ilaykid/robi-firmware/case/Robi_v4/README.md

# רובי (Robi) – מארז רובוט ל-Waveshare ESP32-S3-Touch-AMOLED-1.75 (גרסה 4, "רובי החסון")

מארז מודפס בתלת־ממד ללוח **ESP32-S3-Touch-AMOLED-1.75 בגרסה הרגילה, בלי קופסה (מק"ט 31261)**.
אותה דמות ואותן התאמות ללוח כמו ב-v3.1 (המסך, PWR, BOOT, USB-C, microSD, מיקרופונים), אבל בנוי להחזיק מעמד מול ילדים.
מידות הלוח נלקחו משרטוט המידות של Waveshare ולא אומתו מחדש מאז, ולכן מדפיסים קודם את `fit_test` ואת שני חלקי הראש.

**גודל:** ראש 72×68×28 מ"מ, גוף 62×40×42 (82 מ"מ רוחב עם הידיים), בסיס 78×78, גובה כ־143 מ"מ כולל האנטנה.

## מה השתנה ב-v4 (29.10.2026)
| מה | ב-v3.1 | ב-v4 |
|---|---|---|
| קירות | 2.2 מ"מ | **3.2 מ"מ** |
| צוואר | צינור בקוטר 14 מ"מ, מודבק | **חוליה בקוטר 30 מ"מ**. שני ברגי M3×20 מהדקים ראש, חוליה וגוף |
| בסיס | 3 מ"מ, רגליים | **לוח בעובי 8 מ"מ, 78×78**, בולט 24 מ"מ מאחורי הגוף. כיס למשקולת. 4 ברגי M3 |
| אוזניים | 3 מ"מ, פינים של 2 מ"מ | 5 מ"מ, פינים של 3 מ"מ |
| אנטנה | גבעול 3.4 מ"מ | גבעול 6 מ"מ, כדור 13 מ"מ, יושבת בשקע עם שיפוע |
| יציבות | נופל אחורה מדחיפה של כ־35 גרם במרכז המסך | **כ־89 גרם**, ועם 44 גרם משקולת בכיס **כ־110 גרם** (פי 3) |
| משקל | כ־99 גרם | כ־186 גרם בלי משקולת (כולל הלוח, הסוללה והרמקול) |

## תוכן התיקייה
| קובץ | מה זה | כיוון הדפסה | PLA משוער |
|---|---|---|---|
| `robi_fit_test.stl` | **להדפיס ראשון!** טבעת ניסיון לבדיקת התאמת הזכוכית | כמו שהוא | 3 גרם |
| `robi_head_front.stl` | חזית הראש (פנים) | הפנים על המשטח (כבר מסובב) | 12 גרם |
| `robi_head_back.stl` | גב הראש עם עמודי הברגים | הגב על המשטח (כבר מסובב) | 25 גרם |
| `robi_body.stl` | גוף עם רשת לרמקול, לב וידיים | הפוך, החלק העליון על המשטח (כבר מסובב) | 37 גרם |
| `robi_base.stl` | בסיס עם כיס למשקולת, מגש לסוללה ועמודים לרמקול | כמו שהוא | 49 גרם (במילוי 100%) |
| `robi_neck.stl` | חוליית הצוואר | כמו שהוא | 5 גרם |
| `robi_antenna.stl` | אנטנה | עומדת על הפין | 2 גרם |
| `robi_ear_left.stl` | אוזן שמאל, טבעת סביב ה-USB-C | הפינים למעלה | 1 גרם |
| `robi_ear_right.stl` | אוזן ימין, עם חלון לכרטיס microSD | הפינים למעלה | 1 גרם |
| `robi_pwr_button.stl` | פין לחיצה, אורך רגיל. **מדפיסים 2:** ל-PWR ול-BOOT | עומד על הכובע | 0.3 גרם |
| `robi_pwr_button_short.stl`, `robi_pwr_button_long.stl` | אותו פין, קצר או ארוך ב־0.4 מ"מ | עומד על הכובע | 0.3 גרם |
| `robi.scad` | קובץ המקור הפרמטרי (OpenSCAD) | — | — |

**סה"כ כ־136 גרם PLA.** כל החלקים מודפסים בלי תמיכות (supports).

## גישה לכל רכיבי הלוח
| רכיב בלוח | איך מגיעים אליו |
|---|---|
| מסך מגע | חלון של 47 מ"מ עם שיפוע. אצבע מגיעה כמעט עד הקצה התחתון |
| כפתור PWR | פין כתום בפינה הימנית העליונה. מדליק, והחזקה של 4 שניות מכבה |
| כפתור BOOT | פין כתום בפינה הימנית התחתונה. לחיצה מתחילה או עוצרת שיחה. **לחיצה בזמן ההדלקה פותחת הגדרת Wi-Fi**, אז מחכים שהפרצוף יופיע |
| USB-C | דרך האוזן השמאלית, פתח 14.4×8.8 מ"מ |
| חריץ microSD | דרך החלון באוזן הימנית, עם פינצטה |
| מיקרופונים | שני חורים בגב הראש |

## הגדרות הדפסה
- **חומר:** PLA או PETG.
- **בסיס:** **מילוי 100%** (או לפחות 50%). הוא המשקולת של רובי.
- **שאר החלקים:** 4 קירות, מילוי 20%, שכבה 0.2 מ"מ. לחזית הראש עדיף 0.16, והשכבה הראשונה צריכה להיות נקייה.
- **צבעים מומלצים:** ראש וגוף לבנים. אוזניים, צוואר ובסיס בתכלת. אנטנה ופינים בכתום.

## חומרה נדרשת
| פריט | כמות |
|---|---|
| Waveshare ESP32-S3-Touch-AMOLED-1.75 (31261) | 1 |
| רמקול 2030, 8Ω 2W (30×20×6.8 מ"מ), כבל של לפחות 10 ס"מ | 1 |
| סוללת LiPo 1S עם מעגל הגנה (ראו למטה) | 1 |
| ברגי **M2×16** (לוח לראש). ברגי מכונה, לא ברגים לפלסטיק | 3 |
| ברגי **M2×20** (חיבור שני חלקי הראש) | 4 |
| ברגי **M3×20** (ראש, צוואר וגוף) | 2 |
| ברגי **M3×12** (בסיס לגוף, מלמטה) | 4 |
| משקולת לכיס בבסיס: מטבעות או דסקיות פלדה, עד 44 גרם | — |
| דבק CA לאוזניים ולאנטנה, ודבק לא חובה למשקולת | מעט |
| 4 רגליות סיליקון דביקות מתחת לבסיס | 4 |

### איזו סוללה נכנסת
| מידה (כולל כרטיס ההגנה) | מקסימום |
|---|---|
| אורך (הצד שממנו יוצאים החוטים) | 50 מ"מ |
| עובי | 15 מ"מ |
| גובה (כשהסוללה עומדת) | 31 מ"מ |
| אורך החוטים עד המחבר | לפחות 12 ס"מ |
| מחבר | MX1.25 דו־פיני, **והקוטביות חייבת להתאים ללוח** |

מתאים: 103040 (1000–1200mAh), ובדוחק גם 104050 (1500–1800mAh) אם הגובה שלו עד 31 מ"מ כשהוא עומד.

## סדר הרכבה
1. **בדיקת התאמה:** הדפס את `fit_test` והנח עליו את הלוח עם הזכוכית כלפי מטה. הזכוכית צריכה להיכנס בלי כוח ובלי משחק. אם צריך, שנה את `pocket_d`.
2. **בדיקה בראש:** הדפס את שני חלקי הראש, הנח בהם את הלוח, ובדוק ש-USB-C ו-microSD מול הפתחים ושהפינים לוחצים ("קליק").
3. **כפתורים:** הנח פין מהצד בכל אחד משני חצאי התעלות בחזית הראש. הכובע בחוץ, הטבעת הקטנה בתוך החלק הרחב של התעלה. בוחרים אורך לכל כפתור בנפרד:
   - לחיצה לא עושה כלום: פין `long`.
   - PWR מתנהג כאילו לחוץ כל הזמן: פין `short`.
   - **BOOT: אם רובי לא עולה (מסך שחור), הפין ארוך מדי**, כי BOOT לחוץ בהדלקה מכניס את הלוח למצב צריבה. פין `short`.
4. **מסך:** הנח את הלוח בחזית הראש. ה-USB-C פונה **שמאלה** כשמסתכלים על הפנים.
5. **רמקול:** החלק אותו בין המסילות בגוף מלמטה, צד הקול לרשת.
6. **כבלים:** השחל את כבלי הרמקול והסוללה מלמטה דרך החור בגב העליון של הגוף ודרך החוליה.
7. **צוואר:** הנח את החוליה על הגוף, הצד הרחב למטה, כך ששני החורים שלה מעל שני החורים בגוף. הנח עליה את **גב הראש** (החלק הבולט של החוליה נכנס לשקע ברצפת הראש). הכנס את שני ברגי **M3×20** מבפנים, דרך רצפת הראש והחוליה, לתוך הגוף, והדק.
8. **חיבור:** חבר את הרמקול (SPK) ואת הסוללה (BAT) ללוח. **בדוק את הקוטביות של הסוללה לפני החיבור.**
9. **סגירת הראש:** החלק את חזית הראש (עם הלוח והפינים) על גב הראש. 4 ברגי **M2×20** בפינות מאחור, ואחר כך 3 ברגי **M2×16** דרך העמודים לתוך תושבות הפליז של הלוח. להדק עד שזה יושב, **לא חזק**.
10. **משקולת וסוללה:** הדבק מטבעות או דסקיות פלדה בכיס שבבסיס (עמוק 6 מ"מ, מתחת לסוללה ומאחוריה), עד שהן בגובה פני הבסיס. העמד את הסוללה על הבסיס, מאחורי המעקה הנמוך.
11. **בסיס:** סגור את הבסיס על הגוף ב־4 ברגי **M3×12** מלמטה. הדבק 4 רגליות סיליקון.
12. **קישוטים:** הדבק את האוזניים (הפינים לחורים בצדי הראש) ואת האנטנה.

**החלפת סוללה:** פותחים 4 ברגים מתחת לבסיס, והסוללה נגישה. כדי לנתק אותה מהלוח, פותחים את 4 ברגי הראש ומושכים את הכבל דרך הצוואר.

## פרמטרים שאפשר לשנות ב-`robi.scad`
- `pocket_d`: כיס הזכוכית.
- `pwr_tip_r`, `pwr_adj`: איפה קצה הפין נוגע במתג, ואורכי הפינים. המיקום משוער.
- `wall`: עובי הקירות.
- `base_w`, `base_d`, `base_t`, `ballast`: הבסיס והכיס למשקולת.
- `neck_d`, `neck_gap`: עובי הצוואר וכמה ממנו רואים.
- `clr`: מרווח כללי למדפסת.

לייצוא חלק אחרי שינוי: `openscad -o robi_body.stl -D 'part="body"' robi.scad`

## חשוב לדעת
- **יציבות:** החישוב הוא לדחיפה אופקית במרכז המסך. רובי עדיין קל יחסית, אז שווה להוסיף את המשקולת ואת רגליות הסיליקון. נגיעה קלה מספיקה למסך מגע.
- **USB-C:** הקיר והאוזן עבים יותר, אז הראש של כבל הטעינה צריך להיכנס כ־10 מ"מ פנימה. מתאים לרוב הכבלים שהראש שלהם עד 14×8.5 מ"מ. כבל קלוע עם ראש עבה במיוחד לא ייכנס.
- **microSD:** הכרטיס יושב עמוק יותר. מכניסים ומוציאים עם פינצטה.
- **Wi-Fi:** הלוח מתחבר רק ל-2.4GHz, והאנטנה שלו קטנה. מעמידים את רובי קרוב לראוטר. הפלסטיק לא חוסם את האות.
- **סוללה:** רק עם מעגל הגנה, לבדוק קוטביות, ולא להשאיר בטעינה בלי השגחה במארז סגור. אף בורג לא מכוון לתא הסוללה.
