ilaykid/robi-firmware/assets/faces/angry.png

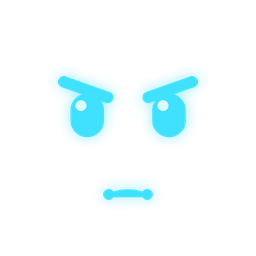
assets/faces/angry.png
