ilaykid/robi-firmware/assets/faces/confident.png

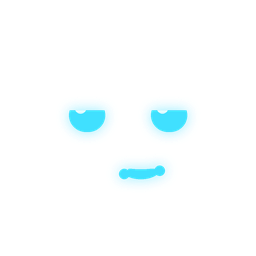
assets/faces/confident.png
