ilaykid/robi-firmware/assets/faces/confused.png

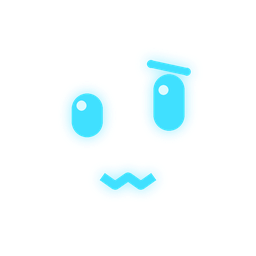
assets/faces/confused.png
