ilaykid/robi-firmware/assets/faces/cool.png

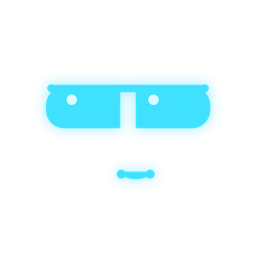
assets/faces/cool.png
