ilaykid/robi-firmware/assets/faces/delicious.png

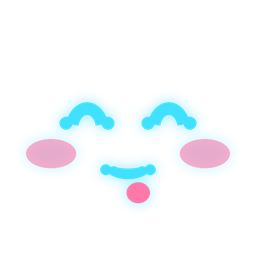
assets/faces/delicious.png
