ilaykid/robi-firmware/assets/faces/embarrassed.png

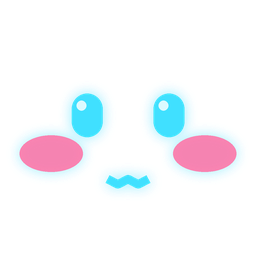
assets/faces/embarrassed.png
