ilaykid/robi-firmware/assets/faces/funny.png

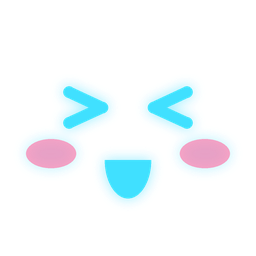
assets/faces/funny.png
