ilaykid/robi-firmware/assets/faces/kissy.png

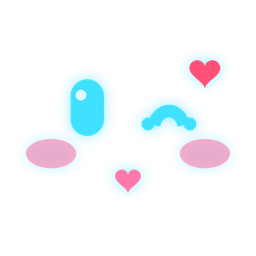
assets/faces/kissy.png
