ilaykid/robi-firmware/assets/faces/loving.png

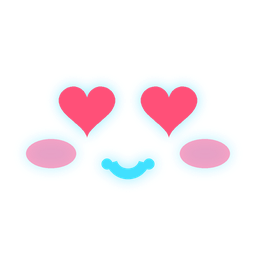
assets/faces/loving.png
