ilaykid/robi-firmware/assets/faces/shocked.png

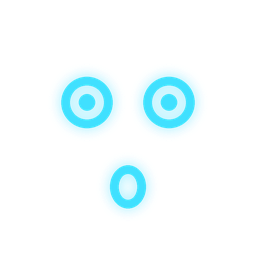
assets/faces/shocked.png
