ilaykid/robi-firmware/assets/faces/sleepy.png

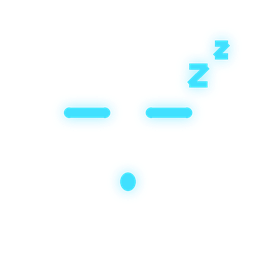
assets/faces/sleepy.png
