ilaykid/robi-firmware/assets/robi_faces_sheet.png

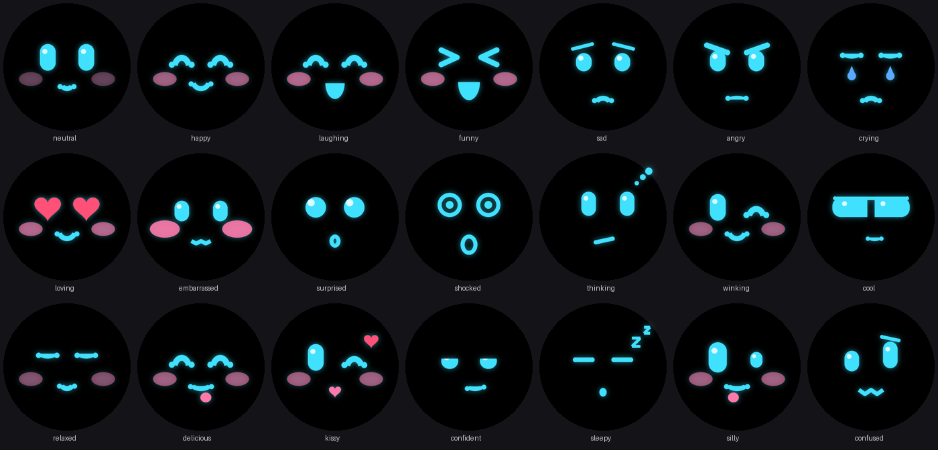
assets/robi_faces_sheet.png
