ilaykid/robi-firmware/case/Robi_v4/robi_pwr_button.stl

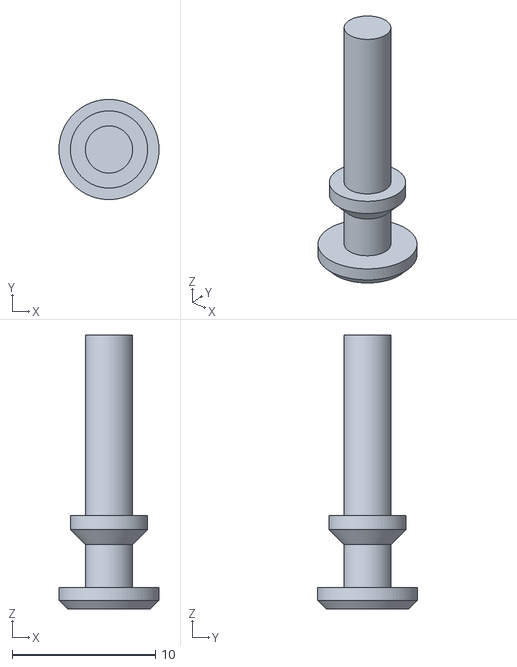
[picture p14: CAD file, 2026-11-11]
case/Robi_v4/robi_pwr_button.stl
7.00 x 7.00 x 19.2
