ilaykid/robi-firmware/case/Robi_v4/robi_antenna.stl

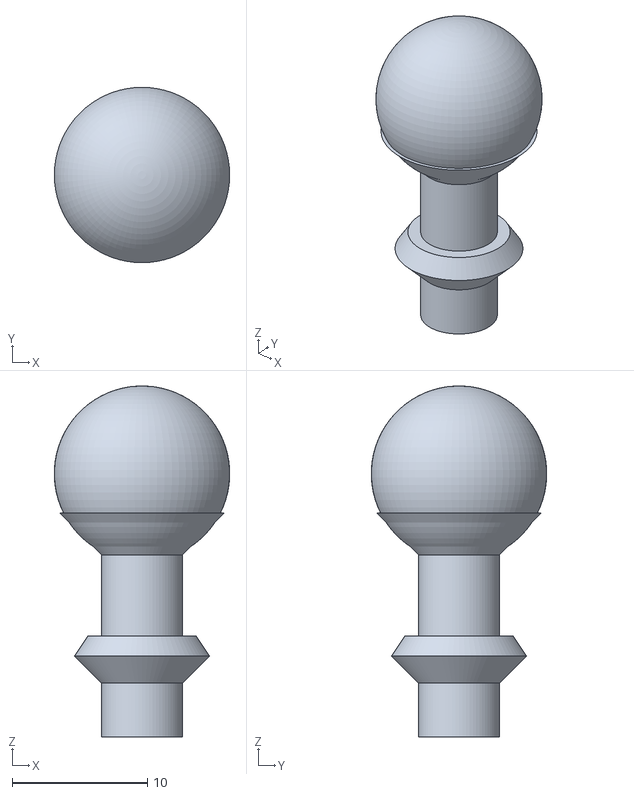
[picture p15: CAD file, 2026-11-11]
case/Robi_v4/robi_antenna.stl
13.0 x 13.0 x 26.0
