ilaykid/robi-firmware/case/Robi_v4/robi_head_front.stl

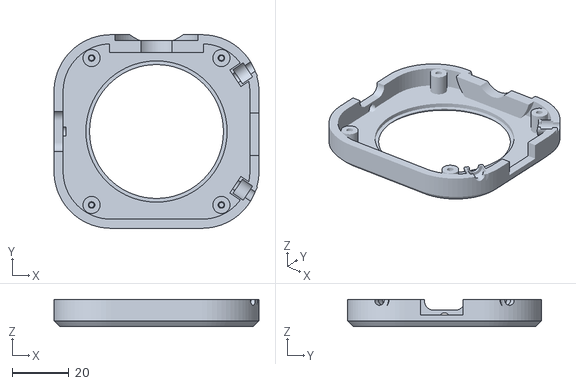
[picture p16: CAD file, 2026-11-11]
case/Robi_v4/robi_head_front.stl
72.0 x 68.0 x 9.60
