ilaykid/robi-firmware/case/Robi_v4/robi_neck.stl

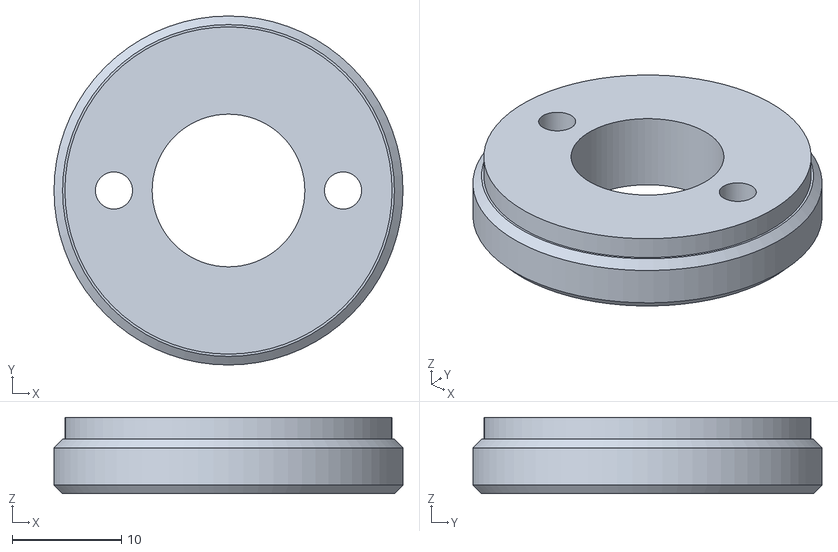
[picture p17: CAD file, 2026-11-11]
case/Robi_v4/robi_neck.stl
32.0 x 32.0 x 7.00
