ilaykid/robi-firmware/case/Robi_v4/robi_pwr_button_long.stl

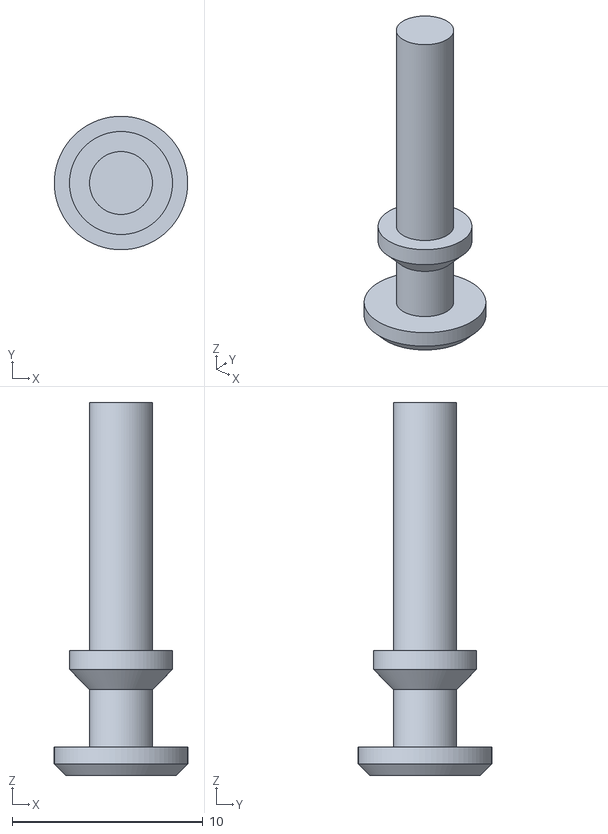
[picture p18: CAD file, 2026-11-11]
case/Robi_v4/robi_pwr_button_long.stl
7.00 x 7.00 x 19.6
