ilaykid/robi-firmware/case/Robi_v4/robi_body.stl

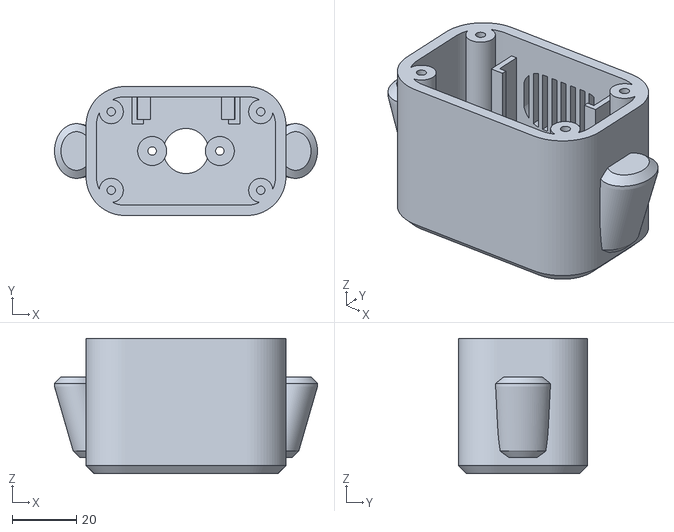
[picture p19: CAD file, 2026-11-11]
case/Robi_v4/robi_body.stl
81.6 x 40.0 x 42.0
