ilaykid/robi-firmware/case/Robi_v4/robi_ear_right.stl

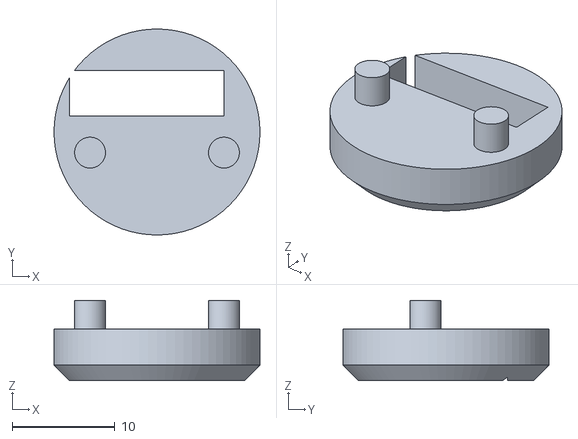
[picture p20: CAD file, 2026-11-11]
case/Robi_v4/robi_ear_right.stl
20.0 x 20.0 x 7.80
