ilaykid/robi-firmware/case/Robi_v4/robi_head_back.stl

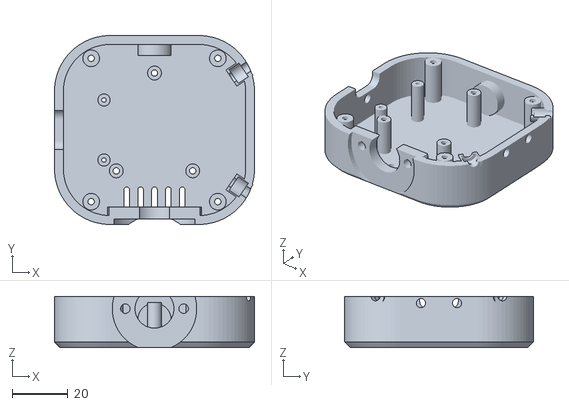
[picture p22: CAD file, 2026-11-11]
case/Robi_v4/robi_head_back.stl
72.0 x 68.0 x 18.4
