ilaykid/robi-firmware/case/Robi_v4/robi_fit_test.stl

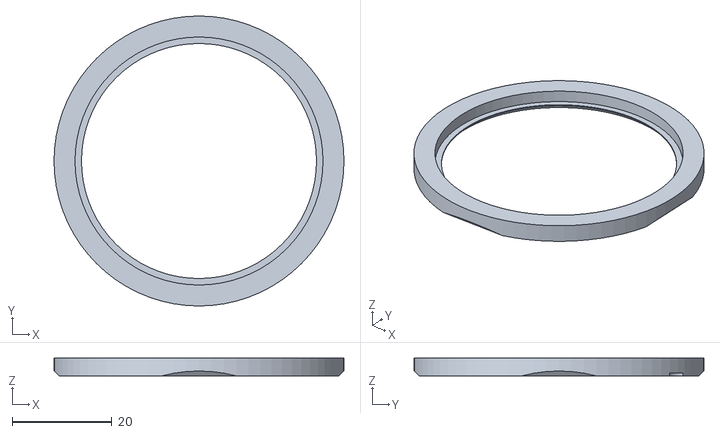
[picture p23: CAD file, 2026-11-11]
case/Robi_v4/robi_fit_test.stl
58.0 x 58.0 x 3.60
