ilaykid/robi-firmware/case/Robi_v4/robi_base.stl

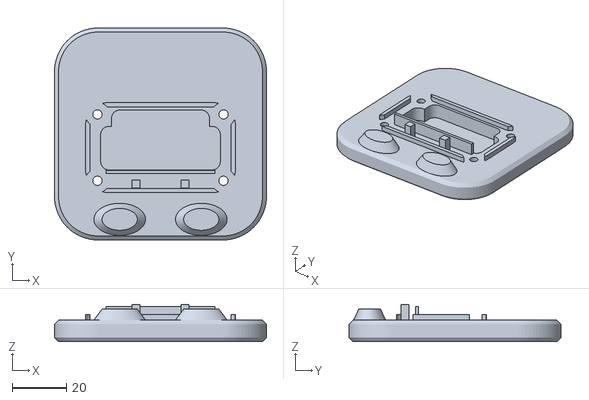
[picture p24: CAD file, 2026-11-11]
case/Robi_v4/robi_base.stl
78.0 x 78.0 x 13.8
