ilaykid/robi-firmware/(list of files, cad)

Other CAD files:
case/Robi_v4/robi_pwr_button_short.stl
