ilaykid/robi-firmware/(commit log)

2026-11-11 feat: OpenRobi v3.0.0 standalone Gemini Live firmware + WebSerial setup wizard
    [robi.scad, robi_antenna.stl, robi_base.stl, robi_body.stl, robi_ear_left.stl, robi_ear_right.stl, robi_fit_test.stl, robi_head_back.stl]
2026-11-11 fix(ui,portal): match 1:1 simulator face/button proportions, keep WiFi awake in standby, enhance mDNS & show IP on screen
2026-11-12 fix(ui): force LTR direction on IP/robi.local pill and align kid buttons & face layout with 466x466 simulator
2026-11-12 fix(nvs): flush memories and model usage from internal SRAM timer task
2026-11-12 docs: add live wizard links, affiliate BOM cards, 3D case options, quota & security docs
2026-11-12 docs: embed AliExpress affiliate search link and recommend speaker+battery bundle
2026-11-12 style(wizard): fix hardware/case button text wrapping and 2-col layout
2026-11-12 fix(power,mdns): unlock AXP2101 2A VBUS limit, schedule tool NVS on SRAM, and add mDNS NSEC + TTL 255 for phones
